DECHU05/Noname/docs/Mechanical.md

# CRTC 智能机器人小车项目日志 - 机械篇

本机器人的创作灵感参考过多种工程车的结构（比如叉车），最后决定了灵感来源：挖掘机。全机采取了比较保守的设计方法，以保证更好的稳定性。

## 一、底盘结构设计与迭代

### 1. 现行结构：麦克纳姆轮方案与局限性

> 📅 9月28日-10月1日

底盘最初采用 4 个 TT 马达搭配麦克纳姆轮的方案，电机支架与主体车架由亚克力板切割成型，并使用螺栓紧固。该方案在初期平整场地上实现了全向移动的良好效果。但在实战推演中，我们发现麦轮斜向小滚轮摩擦力有限，爬坡时容易打滑，在高台边缘被对方挤压时容易失稳。

### 2. 方案变更：转型 60mm 胶轮底盘（研发中）

> 📅 10月11日-10月12日

基于摩擦力和实战稳定性的考量，我们将底盘方案变更为 60mm 胶轮方案，目前尚未装车，**车上继续使用麦轮**。具体调整如下：

*   轮距与轴距调整：重新设计了电机安装支架，调整了传动轴长度以适应 60mm 胶轮尺寸。
*   重心下沉与后移：将电池仓和配重块重新布局，尽量安置在底盘中心偏后、偏低的位置以增强稳定性。
*   结构防断裂：对机械臂承重的亚克力转角处进行圆角处理，防止应力集中断裂。
*   加工与固定：在现有亚克力底盘基础上进行局部切割改造，采购螺丝和轴承加固结构，并使用电工胶布和扎带对线缆进行绝缘与固定。

### 3. 驱动转向方式的选择

> 📅 10月11日-10月12日

配合胶轮底盘，机械组与电控组共同探讨了两种转向结构的可行性：一是利用左右轮差速实现转向（结构更简单，空间利用率高）；二是前轮增加舵机转向机构（转向逻辑更像真车，但需要额外的结构安装空间）。目前，底盘结构倾向于预留可兼容这两种方案的安装孔位。

## 二、机械臂结构设计与迭代

### 1. 现行结构：六舵机与机械干涉

> 📅 10月1日-10月7日

机械臂最初设计为 6 个 SG90 舵机（5 自由度加夹爪）的居中布局结构。但在组装测试中出现了严重的机械干涉与舵机堵转问题。我们发现是手动强拧舵机导致内部角度错位，后续通过先给舵机通电归中（90度，脉宽307），在锁死状态下再安装摇臂和连杆，解决了装配问题。

### 2. 方案精简：从六舵机到三舵机（已定型，尚未投用）

> 📅 10月8日-10月12日

考虑到实战需求，我们完成了三舵机两杆结构的设计定型。精简后，抓取逻辑更清晰，操作手反应更快，供电系统也更稳定。三颗舵机均布置在机械臂的**中轴**上，重心不易偏移，车体不容易侧翻；底座预留额外舵机的安装位置，用于后续实现底盘旋转。期间，我们手上的标准件 3D 模型和实际舵机存在尺寸差异，后续经过调整模型尺寸解决。

该结构刚刚定型，3D 打印件已完成试装，底座尚未制作，暂未装车；**车上现役仍为六舵机方案。**

### 3. 抓取机构的验证

> 📅 10月12日

针对机械爪的实际抓取效果，我们考虑过二爪、三爪和四爪三种方案：三爪和四爪在实际操作中很容易互相卡住，最终确定采用二爪。机械组随后调整了爪子的设计。后续我们将针对方块模型在真实场地进行抓取测试，以验证夹取机构的兼容性和抓取稳定性。

## 三、物理防护设计

### 1. 防跌落与防翻车结构

> 📅 10月10日-10月12日

为了在遭到对方挤压或发生碰撞时保持车体稳定，我们在机械结构上进行了针对性强化：

*   计划在车体后方预留并加装防翻辅助轮的位置，以应对加速冲坡或被推挤时可能出现的后翻风险。
*   采用低重心的布局方式，确保在受到横向推挤力时，车体不易发生侧翻，而是产生滑动摩擦，从而化解外力。
*   将电路零件整体重心靠后布局，进一步增加后轮下压力，防止车辆在起步、爬坡或受到正面冲击时发生后翻。

## 四、空间布局与后续规划

### 1. 空间布局优化

> 📅 10月12日

目前整车的物理结构已基本定型。亚克力底盘、六舵机机械臂、电池仓及驱动板已全部固定在车体上。我们正在对全车线缆进行最后的整理和加固，确保剧烈震动下不会发生线束松脱。

### 2. 下一步规划

> 📅 10月12日

*   完成 60mm 胶轮底盘的实物装配与电控联调。
*   为已采购的 K230D 视觉模块预留外部安装支架和空间位置。
*   进行整车的实地越障测试，调整重心和摩擦力的最佳配比。
