DECHU05/Noname/docs/机械篇.md

# CRTC 智能机器人小车项目日志 - 机械篇

本机器人的结构参考过多种工程车（比如叉车、挖掘机）的作业方式，全机采取了比较保守的设计方法，以保证更好的稳定性。

## 一、底盘结构设计与迭代

### 1. 最初方案：麦克纳姆轮与局限性

> 📅 9月28日-10月1日

底盘最初采用 4 个 TT 马达搭配麦克纳姆轮的方案，并使用螺栓紧固。该方案在初期平整场地上实现了全向移动的良好效果。但在实战推演中，我们发现麦轮斜向小滚轮摩擦力有限，爬坡时容易打滑，在边缘受挤压时容易失稳。

### 2. 方案变更：转型 65mm 胶轮底盘

> 📅 10月11日-10月12日

基于摩擦力和实战稳定性的考量，我们将底盘方案从麦克纳姆轮变更为 65mm 胶轮，原麦轮方案随后被整体替换。具体调整如下：

*   轮距与轴距调整：重新设计了电机安装支架，调整了传动轴长度以适应 65mm 胶轮尺寸。
*   重心下沉与后移：将电池仓和配重块重新布局，尽量安置在底盘中心偏后、偏低的位置以增强稳定性。
*   结构防断裂：对机械臂承重的转角处进行圆角处理。
*   加工与固定：在现有底盘基础上进行局部切割改造，采购螺丝和轴承加固结构；电路部分改用洞洞板焊接、螺栓固定，并用电工胶布和扎带对线缆做绝缘与固定。
*   公差与实测：全车 3D 打印件统一留 0.2mm 公差，以补偿打印材料的流动特性；关键配合尺寸不直接用图纸默认值，而是用微分尺和螺旋测微仪实测后重新建模。

### 3. 驱动转向方式的选择

> 📅 10月11日-10月12日

配合胶轮底盘，机械组与电控组共同探讨了两种转向结构的可行性：一是利用左右轮差速实现转向（结构更简单，空间利用率高）；二是前轮增加舵机转向机构（转向逻辑更像真车，但需要额外的结构安装空间）。目前，底盘结构倾向于预留可兼容这两种方案的安装孔位。

## 二、机械臂结构设计与迭代

### 1. 拾取的方案选型

> 📅 10月1日-10月7日

拾取结构考虑的是**大铲斗方案**：像装载机一样从地面把物资整片铲起来，一次能收得多，我们也完成了完整的建模和双舵机驱动的结构设计。

但赛方给出的能量块并不是集中堆放，铲斗只能贴着地面整片扫过：位置高一点、或者被地形挡住的方块都够不到，也没法针对某一处定点下手。铲斗在“抓取准确性”上先天不足。最终，我们改用**多关节机械臂**，由末端夹爪逐个精确抓取。

### 2. 方案演变：从六舵机到三舵机

> 📅 10月1日-10月12日

机械臂最初设计为 6 个 SG90 舵机（5 自由度加夹爪）的居中布局。组装时出现严重的机械干涉与舵机堵转，排查是手动强拧舵机导致内部角度错位，后续通过先给舵机通电归中（90度，脉宽307）、在锁死状态下再装摇臂和连杆解决。

但六舵机的关节太多，操作手要同时协调六个自由度，实机上很难做出稳定的抓取动作，供电压力也大。**这个方案最终被舍弃**，改为三舵机两杆结构：抓取逻辑更清晰，操作手反应更快，供电也更稳定。三颗舵机均布置在机械臂的**中轴**上，重心不易偏移，车体不容易侧翻；底座预留额外舵机的安装位置，用于实现底盘旋转。期间，我们手上的标准件 3D 模型和实际舵机存在尺寸差异，后续经过调整模型尺寸解决。

这条机械臂不是一次画成的：每一版图纸先做出来试装，把孔位打大、舵机叶片没留准这类问题挑出来，在下一版改掉，一般两到三版才稳定成型。

### 3. 机械臂的结构细节

> 📅 10月8日-10月12日

三舵机两杆的方案定下来之后，真正花时间的是细节。这一版机械臂在结构上做了五件事：

*   **底座换用大扭力舵机**：精简后关节少了，但整条臂连同夹爪的重量仍然全部压在底座上，原来的小舵机带不动，底部改用大扭力舵机——它同时承担整臂重量与底座旋转，对应电控侧的第 4 路通道；并据此改了一版底座外形：收腰造型，受力点全部做圆角，避免应力集中。
*   **独立的连接座**：机械臂与车架之间单独做了一个连接座，侧边开 M2.5 螺丝口，配合底部的小突起做定位，装配后再打磨贴合。
*   **双轴打印连体**：臂节之间不采用螺丝铰接，而是直接把两侧支耳和主体 3D 打印成一个连体件。舵机轴只承受转动方向的力，侧向晃动被连体结构限制住，转动比螺丝装配更稳定。
*   **挖空减重与走线**：在保证结构强度的前提下大量挖空，把整臂重量压下来；中间留出圆孔，舵机线直接从臂内穿过，不挂在外面。
*   **双边受力平衡**：舵机一侧靠自身输出轴带动，另一侧用螺丝连接两段结构，让关节两侧同时受力，避免单边受力带来的偏摆和齿轮磨损。

装配体在 Fusion 里保留了必要关节的转动模拟，装配前就能看出干涉位置和行程不够的关节，不用等打印出来再改。06-机械臂总成-建模

### 4. 抓取机构的验证

> 📅 10月12日

针对机械爪的实际抓取效果，我们考虑过二爪、三爪和四爪三种方案：三爪和四爪在实际操作中很容易互相卡住，最终确定采用二爪。机械组随后把夹爪放大一号，钳口做成啮齿状增加接触摩擦力，齿轮比和臂长也按操作手的实际操作习惯调整，抓取时不用把车身对得很正。后续我们将针对方块模型在真实场地进行抓取测试，以验证夹取机构的兼容性和抓取稳定性。

## 三、物理防护设计

### 1. 防跌落与防翻车结构

> 📅 10月10日-10月12日

为了在对抗碰撞中保持车体稳定，我们在机械结构上做了以下预留与设计：

*   计划在车体后方预留并加装防翻辅助轮的位置，以应对加速冲坡或被推挤时可能出现的后翻风险。
*   采用低重心的布局方式，确保在受到横向推挤力时，车体不易发生侧翻，而是产生滑动摩擦，从而化解外力。
*   将电路零件整体重心靠后布局，进一步增加后轮下压力，防止车辆在起步、爬坡或受到正面冲击时发生后翻。

## 四、整车装配

### 1. 车斗的设计

> 📅 10月13日-10月15日

车斗按场地方块的尺寸和夹爪的取放动作确定容积与开口高度：第一版先按最大容量做，试装后发现夹爪进出时行程吃紧，第二版收窄了尺寸、抬高底板，让方块落进来之后不会再被带出去。装配后车斗与机械臂的取放高度对齐。

### 2. 底盘与机械臂的换代

> 📅 10月14日-10月15日

10 月 14 日胶轮到货后，整车统一换成 65mm 胶轮底盘配三舵机机械臂。原来那台麦轮加六舵机的车在这一轮被拆掉并重新装配：驱动模块数量不够用、备用驱动没有针脚需要先补焊，加上六舵机方案已经被舍弃，索性整车的底盘与机械臂一起换成胶轮与三舵机。三舵机结构用到 MG90S、SG90、MG996R 各一个。
最后得出的整车模型如图示：08-整车装配-建模

### 3. 最后装车

> 📅 10月16日-10月18日

10 月 16 日起进入最后装车。

*   **10 月 17 日**：一侧马达的轮轴断裂，更换新马达后恢复。
*   **10 月 18 日**：车厢装上底盘，与机械臂的取放高度对齐。
*   **10 月 18 日**：夹爪在上一版基础上再放大一号，并在钳口内侧加工出防滑凹槽，咬住方块后不容易打滑。
*   全车线缆重新整理固定，为后续的实地测试做准备。

剩余工作是把车拉到真实场地做越障与抓取测试，按实测结果调整重心和摩擦力的配比。

## 开源项目说明

本篇未使用开源项目。结构建模使用 Autodesk Fusion 360 完成；底盘、机械臂、夹爪与车斗等结构件均为团队自行设计。模型见models文件夹。
