DECHU05/Noname/3d/塔克60mm圆弧右麦轮.stl

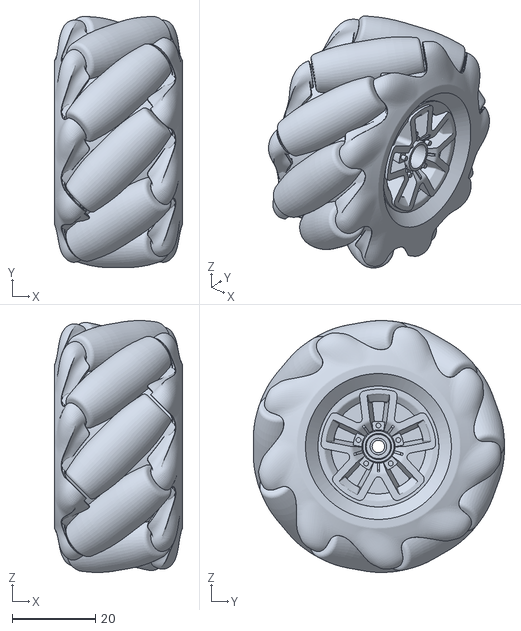
[picture p1: CAD file, 2026-10-16]
3d/塔克60mm圆弧右麦轮.stl
30.8 x 60.3 x 60.5
