DECHU05/Noname/models/抓夹最终版.stl

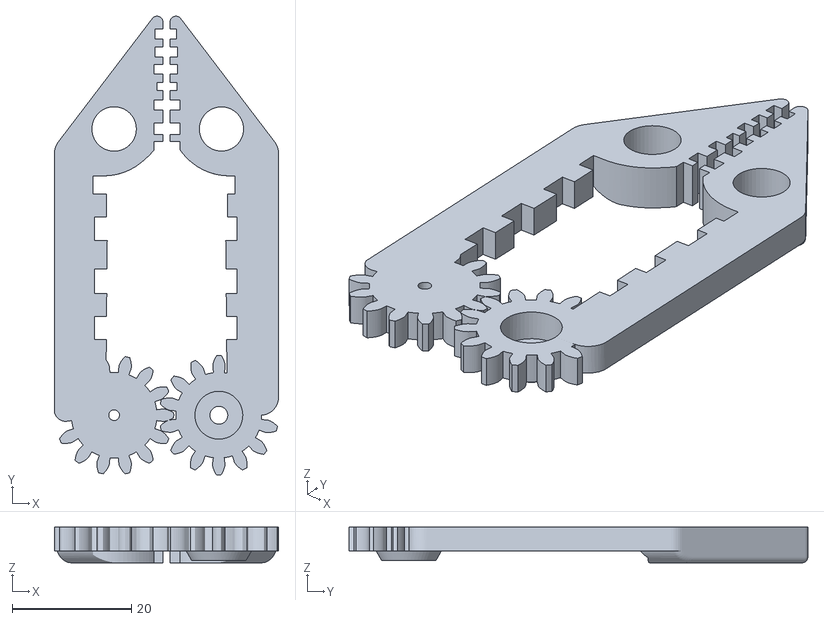
[picture p2: CAD file, 2026-10-18]
models/抓夹最终版.stl
37.6 x 76.9 x 6.00
