DECHU05/Noname/models/01-整机装配体.stl

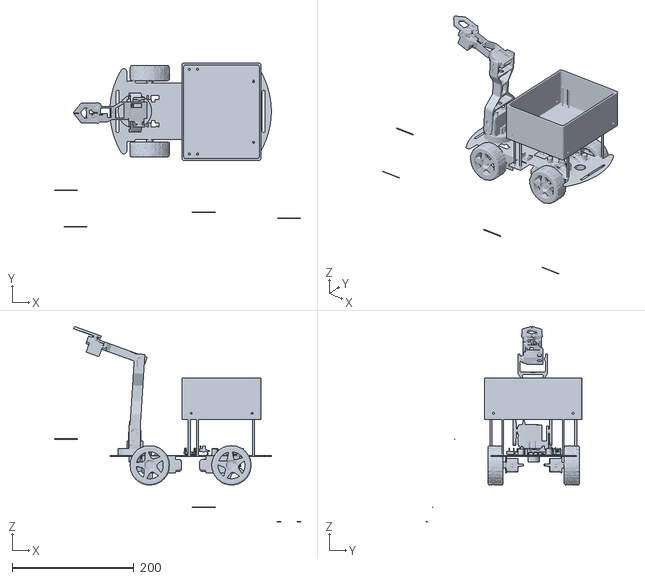
[picture p3: CAD file, 2026-10-18]
models/01-整机装配体.stl
403.7 x 269.3 x 320.4
