DECHU05/Noname/models/车铲原方案.stl

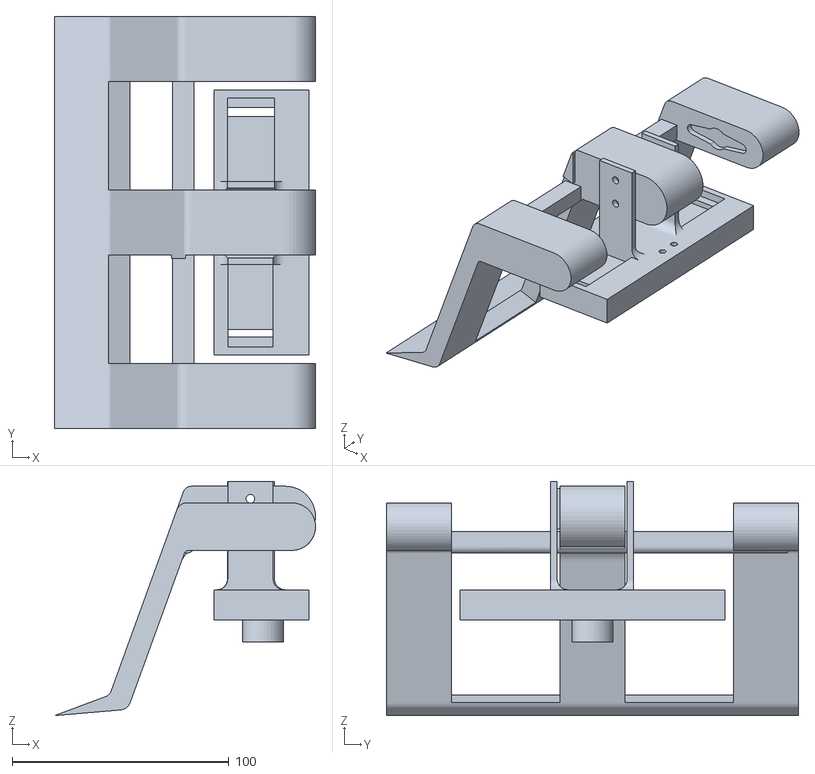
[picture p4: CAD file, 2026-10-18]
models/车铲原方案.stl
120.4 x 190.0 x 108.0
