DECHU05/Noname/3d/车底座.stl

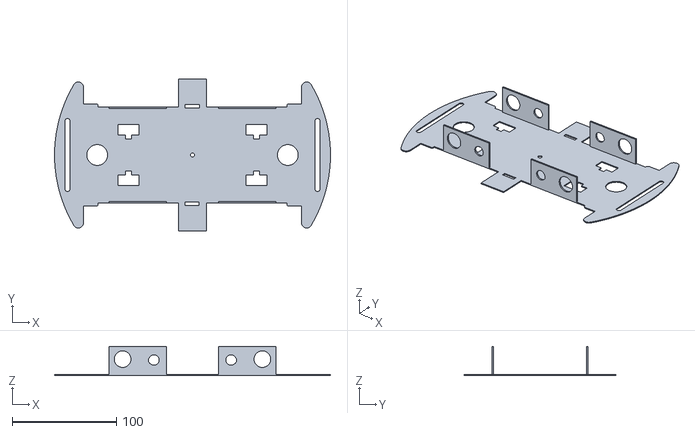
[picture p5: CAD file, 2026-10-16]
3d/车底座.stl
264.9 x 146.3 x 28.0
