DECHU05/Noname/models/车厢.stl

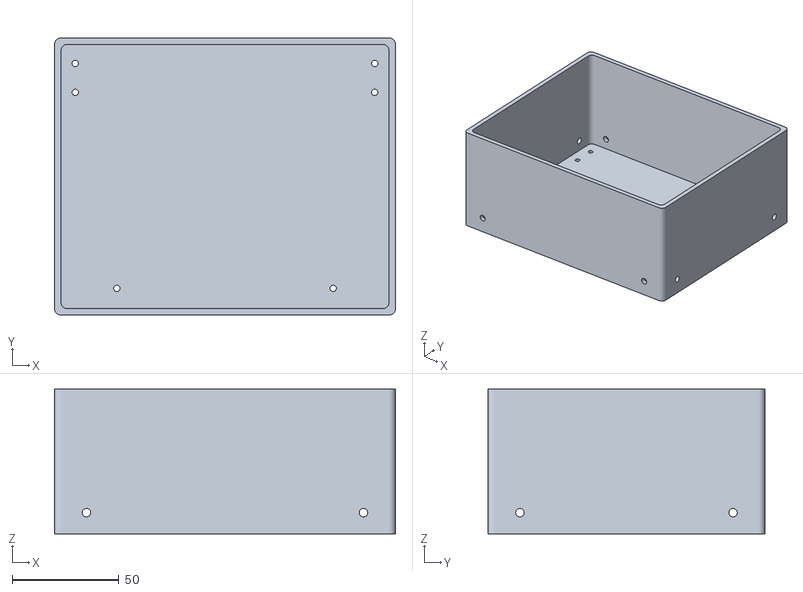
[picture p6: CAD file, 2026-10-16]
models/车厢.stl
160.0 x 130.0 x 68.0
