DECHU05/Noname/3d/能量方块.stl

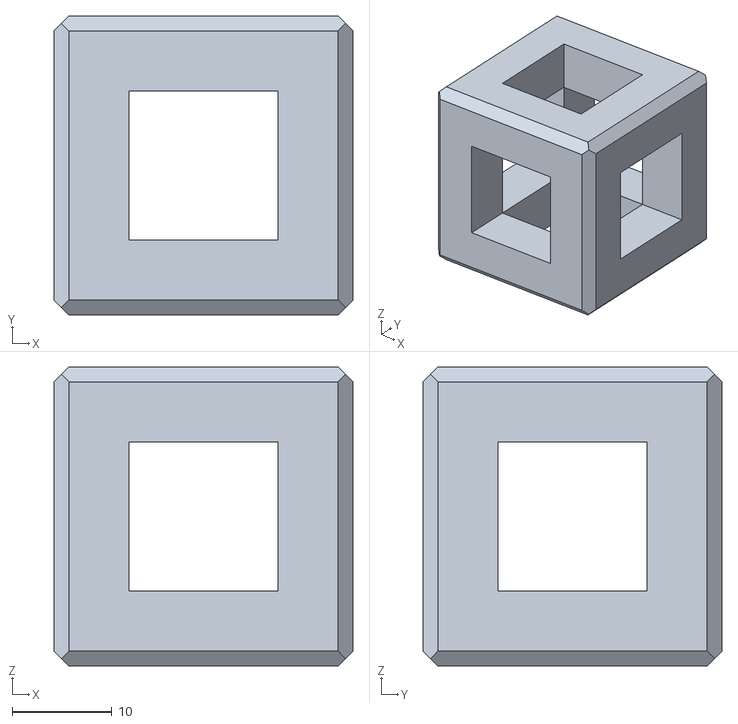
[picture p7: CAD file, 2026-10-16]
3d/能量方块.stl
30.0 x 30.0 x 30.0
