DECHU05/Noname/models/机械臂-第二支架.stl

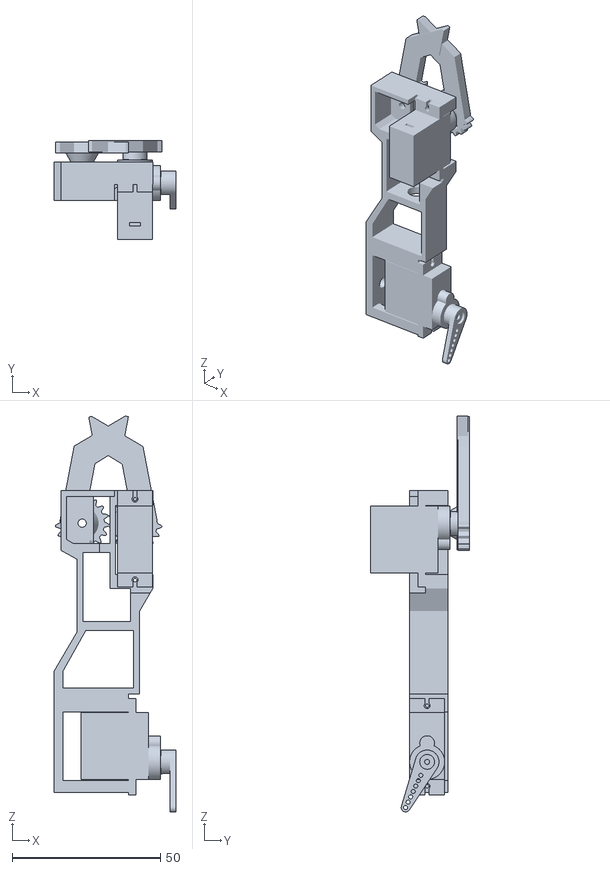
[picture p8: CAD file, 2026-10-16]
models/机械臂-第二支架.stl
41.0 x 33.2 x 133.4
