DECHU05/Noname/3d/机械臂-连杆.stl

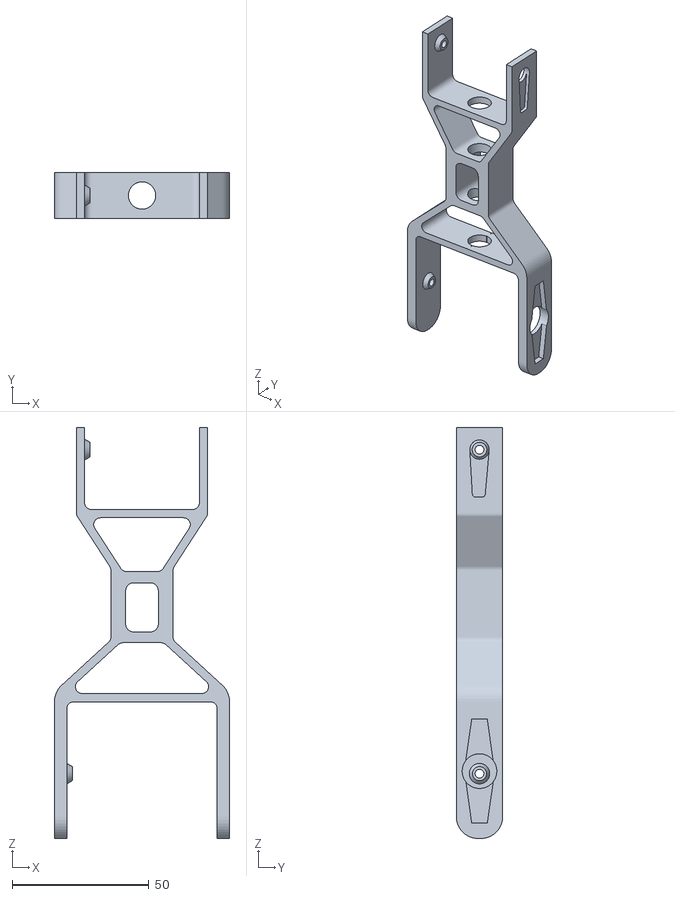
[picture p9: CAD file, 2026-10-16]
3d/机械臂-连杆.stl
64.0 x 17.0 x 150.3
