DECHU05/Noname/models/机械臂-总成.stl

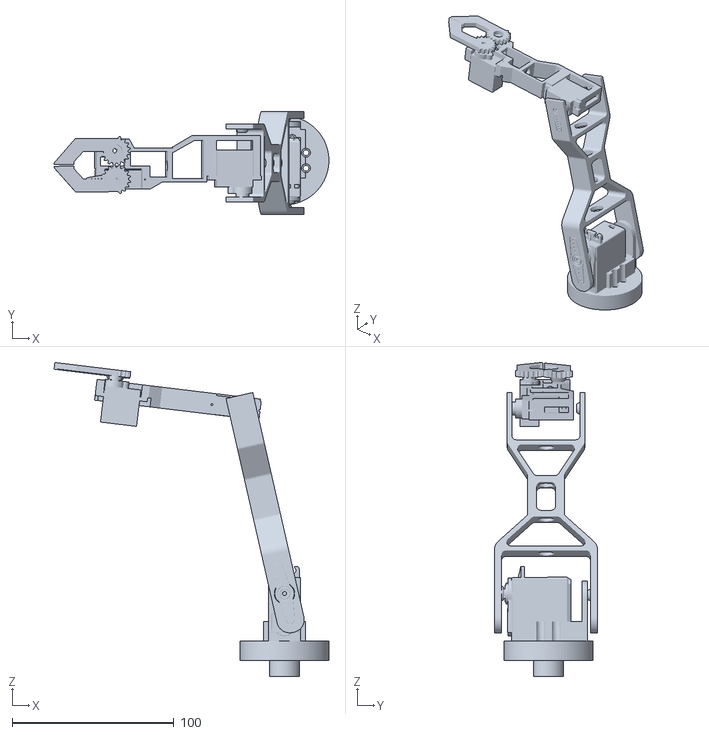
[picture p10: CAD file, 2026-10-16]
models/机械臂-总成.stl
170.1 x 64.0 x 194.3
