DECHU05/Noname/models/夹爪.stl

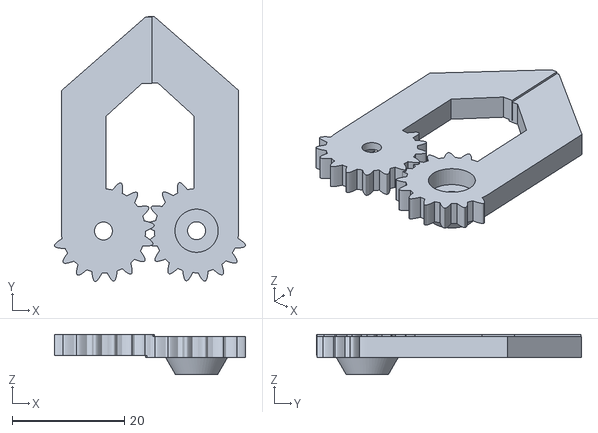
[picture p11: CAD file, 2026-10-16]
models/夹爪.stl
34.1 x 47.2 x 7.16
