DECHU05/Noname/(list of files, cad)

Other CAD files:
3d/04-麦轮（右侧）.stl
3d/整机装配体.stl
