DECHU05/Noname/(commit log)

2026-10-09 Create machine.md
    机器人设计进度
2026-10-11 Update project log for electronic control system
    Expanded the project log for the electronic control system, detailing chassis drive, motor control logic, and remote control setup with PS2 controller. Added sections on debugging, power optimization, and future plans for visual module integration.
2026-10-13 Rename Electronic Control.md to 电控篇.md
2026-10-16 Add 3d STL models (9 files)
2026-10-18 Revise chassis control logic and power supply setup
    Updated the control logic and hardware configurations for the robot's chassis and arm. Adjusted power supply components and refined the PS2 controller integration for improved functionality.
2026-10-18 Create documentation for visual module of robot car
    Added documentation for the visual module of the CRTC intelligent robot car project, detailing block recognition, camera installation, model training, and deployment.
2026-10-18 Include power topology diagram in 电控篇.md
    Added wiring diagram image for power topology.
2026-10-19 Revise section title for robotic arm control
    Updated section title for clarity and added context.
2026-10-19 Revise circuit overview in 电控篇.md
    Updated the circuit overview description to include subsequent sections.
2026-10-20 Refine chassis design descriptions in 机械篇.md
    Removed redundant phrases and improved clarity in the description of the initial chassis design and the changes made to the new chassis design.
