DECHU05/Noname/(notices)

Notices in the files:
codes/freertos-JiaoLun.c:
Copyright (c) 2026 STMicroelectronics.
All rights reserved.
This software is licensed under terms that can be found in the LICENSE file
